pal73/FAT94/3D/KONDUKTOR/KOND.stl

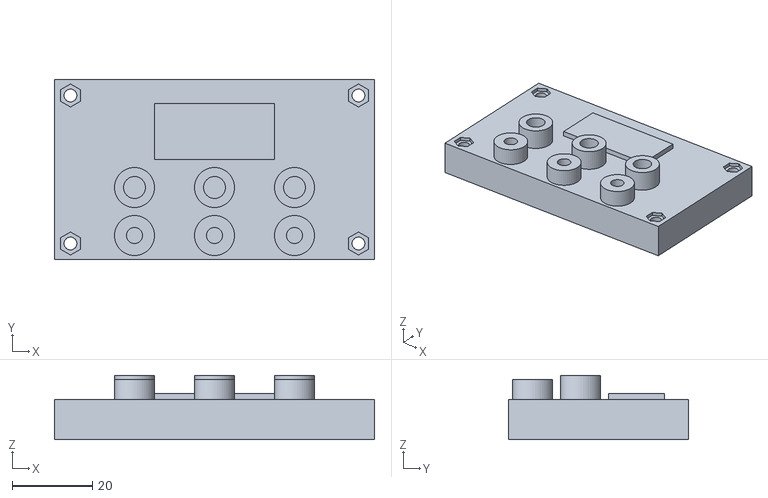
[picture p3: CAD file, 2020-09-20]
3D/KONDUKTOR/KOND.stl
80.0 x 45.0 x 16.0
