pal73/FAT94/(list of files, cad)

Other CAD files:
SOFT/1/fat94.stp
SOFT/Серийное рограммирование/21_09_2020/Release_rogramming.stp
