pal73/FAT94/(list of files, drawings)

Other design files:
HARD/fat94.PcbDoc
HARD/FAT94.PrjPCB
HARD/main.SCHDOC
Sheet1.SchDoc
