pal73/FAT94/(commit log)

2020-05-07 Старт проекта
    [FAT94.PrjPCB, fat94.PcbDoc, main.SCHDOC]
2020-09-21 Доработка программы (9000 часов и символы паузы в третьем режиме). Проект для программирования изделия.
    [Release_rogramming.stp, fat94.stp]
2020-09-21 Кондуктор для пайки
